3d-paws/3D-PAWS-Feather-LoRa-RainSoil/Fritzing/Adafruit_Feather_M0_RS-v20240501.png

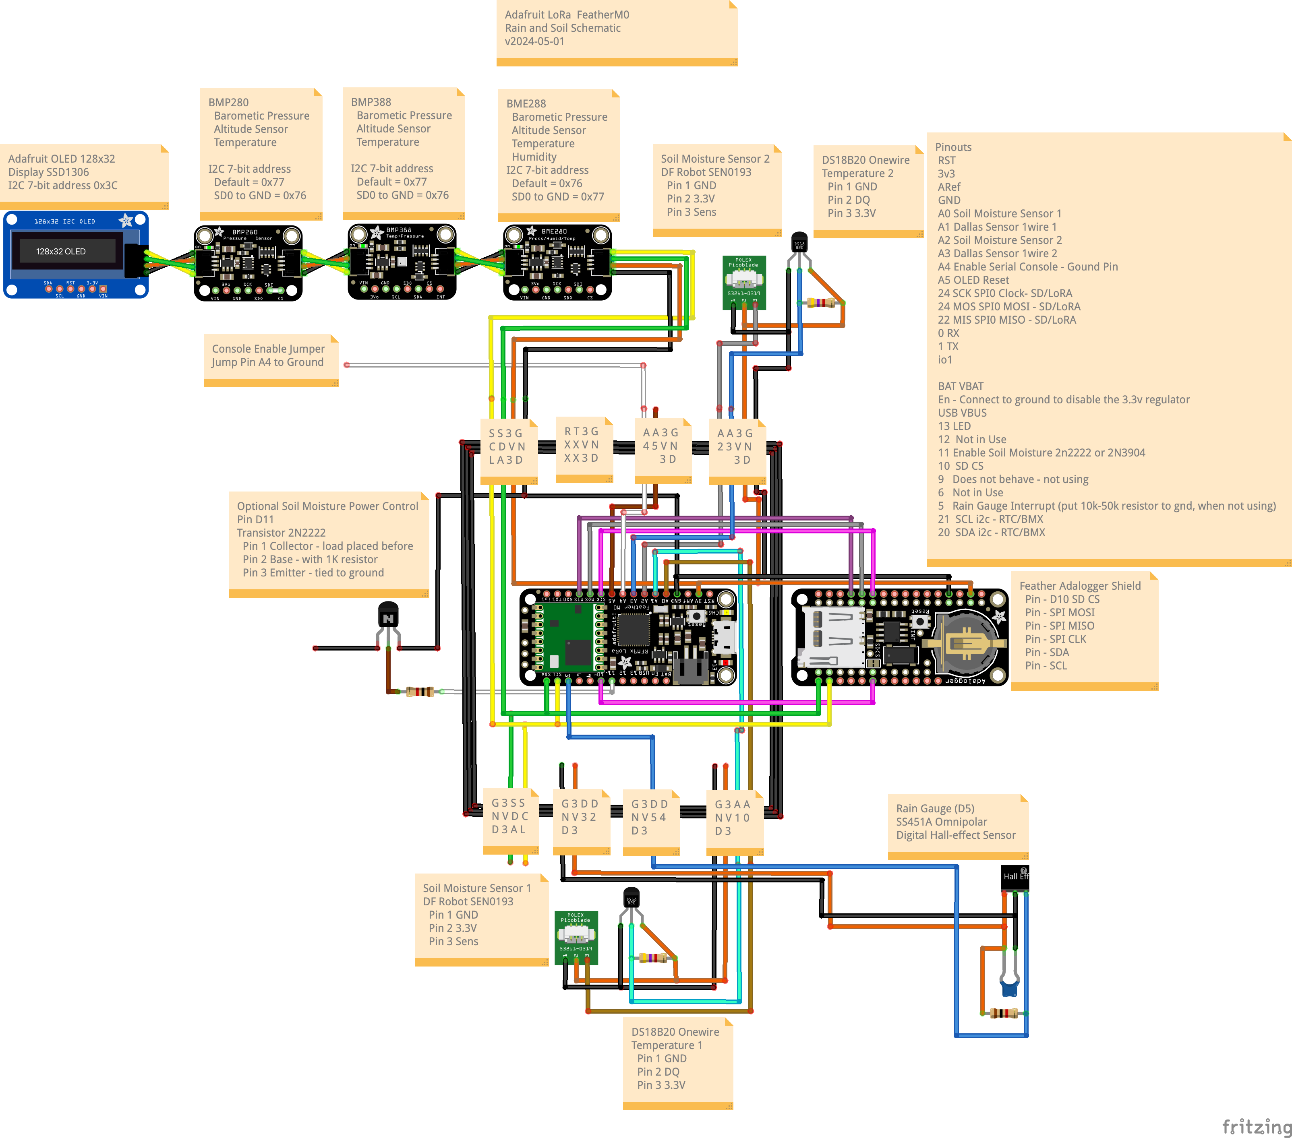
Fritzing/Adafruit_Feather_M0_RS-v20240501.png
