3d-paws/3D-PAWS-Feather-LoRa-RainSoil/(list of files, drawings)

Other design files:
Fritzing/Adafruit_Feather_M0_RS-v20240501.fzz
