3d-paws/3D-PAWS-Feather-LoRa-RainSoil/RS_LoRa_M0/RS_LoRa_M0.ino

#define COPYRIGHT "Copyright [2024] [University Corporation for Atmospheric Research]"
#define VERSION_INFO "RSLoRaM0-240613"

/*
 *======================================================================================================================
 * RainSoil(RS) LoRa
 *   Board Type : Adafruit Feather M0
 *   Description: 
 *   Author: Robert Bubon
 *   Date:   2021-04-05 RJB Initial
 *           2021-05-29 RJB Comments added
 *           2021-12-01 RJB Version 3 Added BMP388 support
 *           2022-08-02 RJB NaN check added to BMX sensors
 *           2022-09-22 RJB Added support for 8 line oled displays
 *                          Send OBS on 0, 15, 30, or 45 minute window
 *           2023-08-07 RJB Countdown 60s on waiting for serial
 *                          Added Quality Checks to sensors values
 *           2023-08-28 RJB had 2 functions for I2C_Device_Exist
 *           2023-08-29 RJB Update function get_Bosch_ChipID()
 *           2023-10-23 RJB Changed to only support 2 Soil and Dallas Sensors                         
 *                          Each Grove connector has 1 Soil and 1 Dallas on Pins
 *                          Added Dynamic display type determination                     
 *                          Updated serial and oled initialization code to match other code bases.
 *           2024-05-01 RJB Moved Rain Gauge from pin 12 to pin 5 so it is on the grove shield connector
 *           2024-06-13 RJB Split code up into include files
 *                          Added CONFIG.TXT support
 *                          Moved LoRa configs to CONFIG.TXT
 *                          Added check for LORA_exists during initialization, If no, then none of the LoRa funcs called
 *                          Move Serial Console from A4 to 12
 *                          Added MCP and SHT sensor support. Not transmitted. Just saved to SD card OBS directory
 *           2024-06-23 RJB Added Copyright
 *                          Moved #define SD_CONFIG from OP.h to SDC.h
 *                          Removed #define W4SC true
 *           2024-11-05 RJB Discovered BMP390 first pressure reading is bad. Added read pressure to bmx_initialize()
 *                          Bug fixes for 2nd BMP sensor in bmx_initialize() using first sensor data structure
 *                          
 * Time Format: 2022:09:19:19:10:00  YYYY:MM:DD:HR:MN:SS
 * 
 * ======================================================================================================================
 * Normal loop operation
 * 
 * If a tip occurs we wake up from low power sleep and increment the tip count in the interrupt handler.
 * Upon wake up the code starts executing after the function "LowPower.sleep(GoToSleepTime);" in the loop() function.
 * The loop() function determines if the full sleep (15min) has transpired.
 *   If so,  an observation is made and transmitted. After, another 15min low sleep period occurs.
 *   If not, it calculates the amount of time left in the 15 minute sleep period.
 *      If this amount of time is 2s or less before next observation,it delays and avoids the sleep.
 *      Otherwise it enters low power sleep for the calculated amount of time.
 * As a result of the above, rain and all other observations have a granularity of 15 minutes
 * ======================================================================================================================
 *                    
 * SEE https://learn.adafruit.com/adafruit-feather-m0-radio-with-lora-radio-module
 * SEE https://learn.adafruit.com/assets/46254 for Pinouts      
 * SEE https://www.microchip.com/wwwproducts/en/ATsamd21g18
 * SEE https://learn.adafruit.com/adafruit-adalogger-featherwing/pinouts
 * SEE https://www.microchip.com/wwwproducts/en/MCP73831 - Battery Charger
 * 
 * Antenna Options
 * https://learn.adafruit.com/adafruit-feather-m0-radio-with-lora-radio-module/antenna-options
 * https://www.changpuak.ch/electronics/bi_quad_antenna_designer.php
 * 
 * Arduino Low Power
 * SEE: https://www.arduino.cc/en/Reference/ArduinoLowPower
 * SEE https://github.com/arduino-libraries/ArduinoLowPower
 *  
 * Arduino/libraries/AES-master/AES_config.h  Modified to fix below problem.
 *     Arduino/libraries/AES-master/AES_config.h:43:18: fatal error: pgmspace.h: No such file or directory
 *     #include <pgmspace.h>
 *                ^~~~~~~~~~~~
 * diff AES_config.h.org AES_config.h
 *     40c40
 *     <     #if (defined(__AVR__))
 *     ---
 *     >     #if (true || defined(__AVR__))
 *     41a42
 *     >  #define printf_P printf
 *
 * Library of Adafruit_BMP280_Library has been modified to enable Forced Mode
 *
 * ======================================================================================================================
 * Pin Definitions
 * 
 * Board Label   Arduino  Info & Usage                   Grove Shield Connector   
 * ======================================================================================================================
 * RST
 * 3V            3v3 Power
 * ARef
 * GND
 * A0            A0       Soil Moisture Sensor 1         Grove A0
 * A1            A1       Dallas Sensor 1wire 1          Grove A0
 * A2            A2       Soil Moisture Sensor 2         Grove A2
 * A3            A3       Dallas Sensor 1wire 2          Grove A2
 * A4            A4       Not in Use                     Grove A4
 * A5            A5       Not in Use                     Grove A4
 * SCK           SCK SPI0 Clock - SD/LoRa
 * MOS           MOSI     Used by SD Card/LoRa           Not on Grove
 * MIS           MISO     Used by SDCard/LoRa            Not on Grove
 * RX0           D0                                      Grove UART
 * TX1           D1                                      Grove UART 
 * io1           DIO1                                    Not on Grove (Particle Pin D9)
   
 * BAT           VBAT Power
 * En            Control - Connect to ground to disable the 3.3v regulator
 * USB           VBUS Power
 * 13            D13      LED                            Not on Grove 
 * 12            D12      Serial Console Enable          Not on Grove
 * 11            D11      Enable Sensors 2n2222/2N3904   Not on Grove
 * 10            D10      Used by SD Card as CS          Grove D4  (Particle Pin D5)
 * 9             D9/A7    Voltage Battery Pin            Grove D4  (Particle Pin D4)
 * 6             D6       Not in Use                     Grove D2  (Particle Pin D3)
 * 5             D5       Rain Gauge Interrupt           Grove D2  (Particle Pin D2)
 * SCL           D3       i2c Clock                      Grove I2C_1
 * SDA           D2       i2c Data                       Grove I2C_1
 * 
 * Not exposed on headers
 * D8 = LoRa NSS aka Chip Select CS
 * D4 = LoRa Reset
 * D3 = LoRa DIO
 * ======================================================================================================================
 * Normal main loop operation
 * 
 * If a tip occurs we wake up increment the tip count in the interrupt handler.
 * Upon wake up the code starts executing after the function "LowPower.sleep(GoToSleepTime);" in the main loop.
 * The main loop determines if the full sleep period (15min) has transpired.
 *   If so,  an observation is made and transmitted. After another 15min sleep period occurs.
 *   If not, It calculates the amount of time left in the 15 minute sleep period.
 *      If This amount of time is 2s or less before next observation,it delays and avoids the sleep.
 *      Otherwise it enters ultra low power sleep for the calculated amount of time.
 * So rain observations have a granularity of 15 minutes
 * ======================================================================================================================
 */

#include <OneWire.h>
#include <SPI.h>
#include <Wire.h>
#include <ArduinoLowPower.h>
#include <SD.h>
#include <Adafruit_BME280.h>
#include <Adafruit_BMP280.h>
#include <Adafruit_BMP3XX.h>
#include <Adafruit_MCP9808.h>
#include <Adafruit_SHT31.h>

#include <RH_RF95.h>
#include <AES.h>
#include <RTClib.h>

#define PCF8523_ADDRESS 0x68       // I2C address for PCF8523


/*
 * ======================================================================================================================
 * System Status Bits used for report health of systems - 0 = OK
 * 
 * OFF =   SSB &= ~SSB_PWRON
 * ON =    SSB |= SSB_PWROFF
 * 
 * ======================================================================================================================
 */
#define SSB_PWRON           0x1     // Set at power on, but cleared after first observation
#define SSB_SD              0x2     // Set if SD missing at boot or other SD related issues
#define SSB_RTC             0x4     // Set if RTC missing at boot
#define SSB_OLED            0x8     // Set if OLED missing at boot, but cleared after first observation
#define SSB_N2S             0x10    // Set when Need to Send observations exist
#define SSB_FROM_N2S        0x20    // Set in transmitted N2S observation when finally transmitted
#define SSB_AS5600          0x40    // Set if wind direction sensor AS5600 has issues
#define SSB_BMX_1           0x80    // Set if Barometric Pressure & Altitude Sensor missing
#define SSB_BMX_2           0x100   // Set if Barometric Pressure & Altitude Sensor missing
#define SSB_HTU21DF         0x200   // Set if Humidity & Temp Sensor missing
#define SSB_SI1145          0x400   // Set if UV index & IR & Visible Sensor missing
#define SSB_MCP_1           0x800   // Set if Precision I2C Temperature Sensor missing
#define SSB_MCP_2           0x1000  // Set if Precision I2C Temperature Sensor missing
#define SSB_LORA            0x2000  // Set if LoRa Radio missing at startup
#define SSB_SHT_1           0x4000  // Set if SHTX1 Sensor missing
#define SSB_SHT_2           0x8000  // Set if SHTX2 Sensor missing
#define SSB_HIH8            0x10000 // Set if HIH8000 Sensor missing
#define SSB_GPS             0x20000 // Set if GPS Sensor missing
#define SSB_PM25AQI         0x40000 // Set if PM25AQI Sensor missing
#define SSB_EEPROM          0x80000 // Set if 24LC32 EEPROM missing

unsigned int SystemStatusBits = SSB_PWRON; // Set bit 0 for initial value power on. Bit 0 is cleared after first obs
bool JustPoweredOn = true;         // Used to clear SystemStatusBits set during power on device discovery

/*
 * =======================================================================================================================
 *  Globals
 * =======================================================================================================================
 */
char msgbuf[RH_RF95_MAX_MESSAGE_LEN+1];   // 255 - 4(Header) + 1(Null) = 252
char *msgp;                               // Pointer to message text
char Buffer32Bytes[32];                   // General storage
int countdown = 1800;        // Exit calibration mode when reaches 0 - protects against burnt out pin or forgotten jumper
unsigned int SendSensorMsgCount=0;        // Counter for Sensor messages transmitted
unsigned int SendType2MsgCount=0;         // Counter for Powerup and Heartbeat messages transmitted
int  LED_PIN = LED_BUILTIN;               // Built in LED

/*
 * ======================================================================================================================
 *  SD Card
 * ======================================================================================================================
 */
#define SD_ChipSelect 10    // GPIO 10 is Pin 10 on Feather and D5 on Particle Boron Board
// SD;                      // File system object defined by the SD.h include file.
File SD_fp;
char SD_obsdir[] = "/OBS";  // Store our obs in this directory. At Power on, it is created if does not exist
bool SD_exists = false;     // Set to true if SD card found at boot

/*
 * ======================================================================================================================
 *  Optipolar Hall Effect Sensor SS451A - Interrupt 0 - Rain Gauge
 * ======================================================================================================================
 */
#define RAIN_GAUGE_PIN  5  // D5
volatile unsigned int rainguage_interrupt_count;
uint64_t rainguage_interrupt_stime; // Send Time
uint64_t rainguage_interrupt_ltime; // Last Time
uint64_t rainguage_interrupt_toi;   // Time of Interupt

/*
 * ======================================================================================================================
 *  Local Code Includes - Do not change the order of the below 
 * ======================================================================================================================
 */
#include "QC.h"                   // Quality Control Min and Max Sensor Values on Surface of the Earth
#include "SF.h"                   // Support Functions
#include "OP.h"                   // OutPut support for OLED and Serial Console
#include "CF.h"                   // Configuration File Variables
#include "TM.h"                   // Time Management
#include "LoRa.h"                 // LoRa
#include "Sensors.h"              // I2C Based Sensors
#include "SDC.h"                  // SD Card
#include "Soil.h"                 // Soil Moaisture, Soil Temp (OneWire), Rain Gauge
#include "OBS.h"                  // Do Observation Processing
#include "SM.h"                   // Station Monitor

/* 
 *=======================================================================================================================
 * seconds_to_next_obs() - do observations on 0, 15, 30, or 45 minute window
 *=======================================================================================================================
 */
int seconds_to_next_obs() {
  now = rtc.now(); //get the current date-time
  return (900 - (now.unixtime() % 900)); // 900 = 60s * 15m,  The mod operation gives us seconds passed in this 15m window
}

void sleepinterrupt() {
  Output("I");
}

/*
 * =======================================================================================================================
 * setup()
 * =======================================================================================================================
 */
void setup() 
{
  // Put initialization like pinMode and begin functions here.
  pinMode (LED_PIN, OUTPUT);
  digitalWrite(LED_PIN, LOW);

  Output_Initialize();
  delay(2000); // Prevents usb driver crash on startup

  Serial_write(COPYRIGHT);
  Output (VERSION_INFO);
  delay (4000);      // Pause so user can see version if not waiting for serial

  // https://forums.adafruit.com/viewtopic.php?f=57&t=174492&p=850337&hilit=RFM95+adalogger#p850337
  // Normally, well-behaved libraries for SPI devices would take care to set CS high when inactive. 
  // But since the SD library does not initialize the radio, pin 8 is left floating.
  // When I need to use the radio again, should I set pin 8 to low?
  // No, the driver will handle it for you. You just have to make sure it is high when not in use.
  
  pinMode(LORA_SS, OUTPUT);
  digitalWrite(LORA_SS, HIGH);
  // pinMode(LORA_SS, INPUT_PULLUP); // required since RFM95W is also on the SPI bus

  // Initialize SD card if we have one.
  SD_initialize();

  if (SD_exists && SD.exists(CF_NAME)) {
    SD_ReadConfigFile();
  }
  else {
    sprintf(msgbuf, "CF:NO %s", CF_NAME); Output (msgbuf);
  }

  // Read RTC and set system clock if RTC clock valid
  rtc_initialize();

  if (RTC_valid) {
    Output("RTC: Valid");
  }
  else {
    Output("RTC: Not Valid");
  }

  rtc_timestamp();
  sprintf (msgbuf, "%s", timestamp);
  Output(msgbuf);
  delay (2000);

  //==================================================
  // Rain Gauge Interrupt Based Sensor
  //==================================================

  // Optipolar Hall Effect Sensor SS451A - Rain Gauge
  rainguage_interrupt_count = 0;
  rainguage_interrupt_stime = millis();
  rainguage_interrupt_ltime = 0;  // used to debounce the tip
  // attachInterrupt(RAIN_GAUGE_PIN, rainguage_interrupt_handler, FALLING);
  LowPower.attachInterruptWakeup(RAIN_GAUGE_PIN, rainguage_interrupt_handler, FALLING);

  //==================================================
  // Soil Moisture and Temperature Sensors
  //==================================================
  ds_initialize();

  //=====================
  // Adafruit i2c Sensors
  //=====================
  bmx_initialize();
  mcp9808_initialize();
  sht_initialize();

  lora_initialize();

  // Set a time to force the first observation
  wakeuptime = now.unixtime();
}

/*
 * =======================================================================================================================
 * loop()
 * =======================================================================================================================
 */
void loop()
{
  static time_t sleep_time = 0;
  time_t time_asleep;
  int GoToSleepTime;
  
  // RTC not set, Get Time for User
  if (!RTC_valid) {
    static bool first = true;

    delay (1000);
      
    if (first) {
      if (digitalRead(SCE_PIN) != LOW) {
        Serial.begin(9600);
        SerialConsoleEnabled = true;
      }  
    
      Output("SET RTC ENTER:");
      Output("YYYY:MM:DD:HH:MM:SS");
      first = false;
    }
    
    if (rtc_readserial()) { // check for serial input, validate for rtc, set rtc, report result
      Output("!!!!!!!!!!!!!!!!!!!");
      Output("!!! Press Reset !!!");
      Output("!!!!!!!!!!!!!!!!!!!");

      while (true) {
        delay (1000);
      }
    }
  }

  //Calibration mode, You can also reset the RTC here
  else if (countdown && digitalRead(SCE_PIN) == LOW) { 
    // Every minute, Do observation (don't save to SD) and transmit - So we can test LoRa
    I2C_Check_Sensors();
 
    if ( (countdown%60) == 0) { // This is here to test LoRa every minute
      OBS_Do(false);
    }
    
    StationMonitor();
    
    // check for input sting, validate for rtc, set rtc, report result
    if (Serial.available() > 0) {
      rtc_readserial(); // check for serial input, validate for rtc, set rtc, report result
    }
    
    countdown--;
    delay (1000);
  }

  // Normal Operation
  else {
    // If we are aggressively interrupting (raining) we don't want to send LoRa messages on every interrupt
    
    now = rtc.now();   
    if (now.unixtime() >= wakeuptime) {   // Upon power on this will be true and OBS_Do will run
      I2C_Check_Sensors();
      OBS_Do(true);
      
      // Shutoff System Status Bits related to initialization after we have logged first observation
      JPO_ClearBits();
    }

    unsigned long stno = seconds_to_next_obs();
      
    if (stno <= 2) {
      // Avoid going to sleep if there is 2s or less time until we need to do an observation
      // This is really here to address going into low power move for a fraction of a second.
      Output("Delay - Not Sleep");
      delay (GoToSleepTime);
    }
    else {  
      Output("Going to Sleep");

      if (LORA_exists) {
        rf95.sleep(); // LoRa will stay in sleep mode until woken by changing mode to idle, transmit or receive.
                      // (eg by calling send(), recv(), available() etc
      }
    
      OLED_sleepDisplay();

      wakeuptime = stno + now.unixtime(); // "now" was updated in the seconds_to_next_obs() function
      LowPower.sleep(stno*1000); // uses milliseconds
 
      OLED_wakeDisplay();   // May need to toggle the Display reset pin.
      delay(2000);
      OLED_ClearDisplayBuffer(); 
      Output("Wakeup");
    }
  }
}
